F1SLP/Tracking-VFO-pour-YAESU-FT-817-et-FT-818-Arduino/Oled screen.jpg

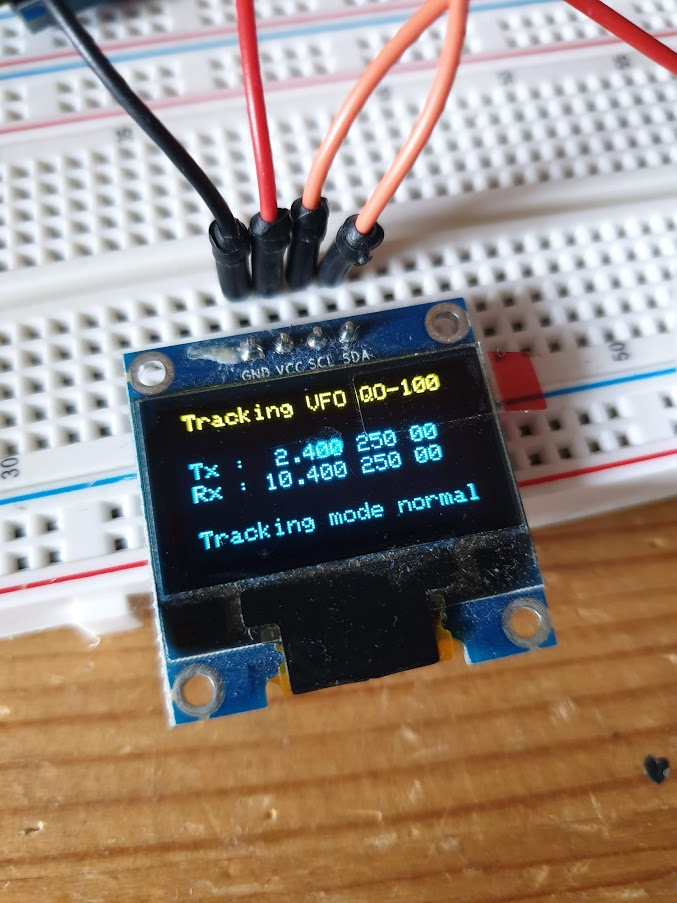
Oled screen.jpg
