F1SLP/Tracking-VFO-pour-YAESU-FT-817-et-FT-818-Arduino/Tracking_LCD_SLP.jpg

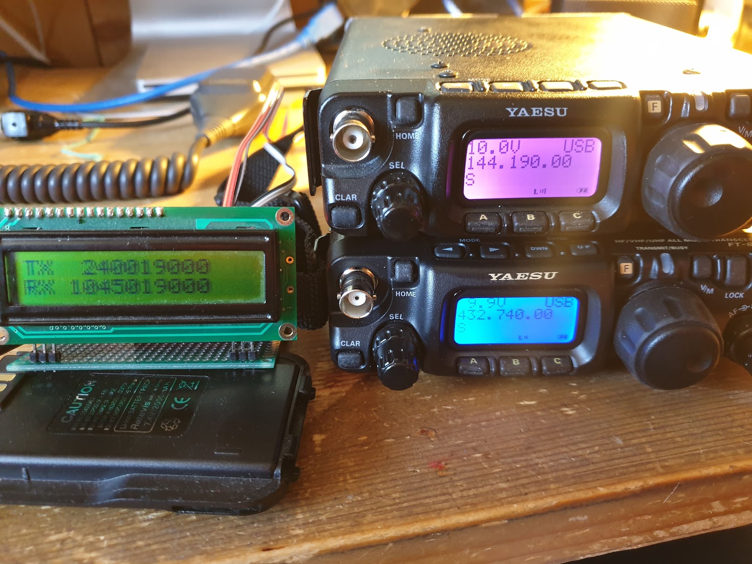
Tracking_LCD_SLP.jpg
