F1SLP/Tracking-VFO-pour-YAESU-FT-817-et-FT-818-Arduino/Schematic_Tracking FT817 LCD I2C_2020-08-15_14-18-44.pdf

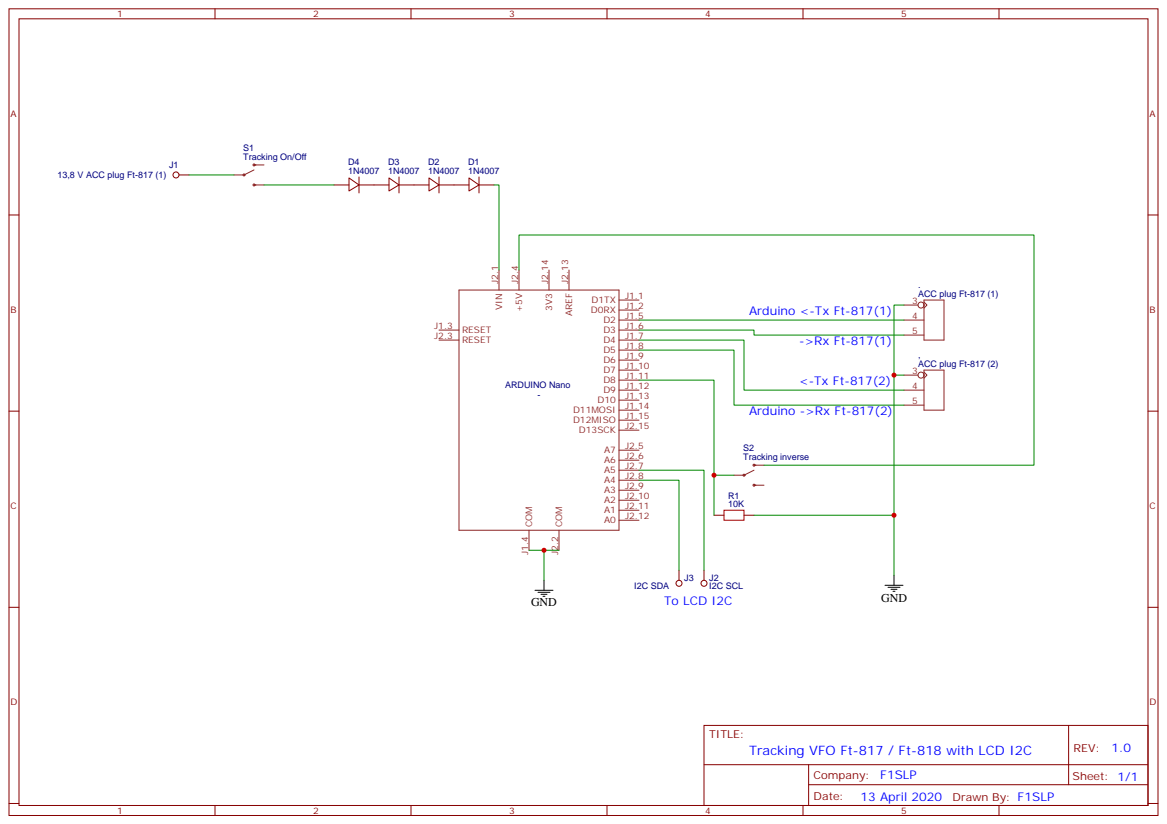
[picture p3: page 1]
