F1SLP/Tracking-VFO-pour-YAESU-FT-817-et-FT-818-Arduino/Schematic_Tracking FT-817 and FT-818_2020-08-15_14-14-17.pdf

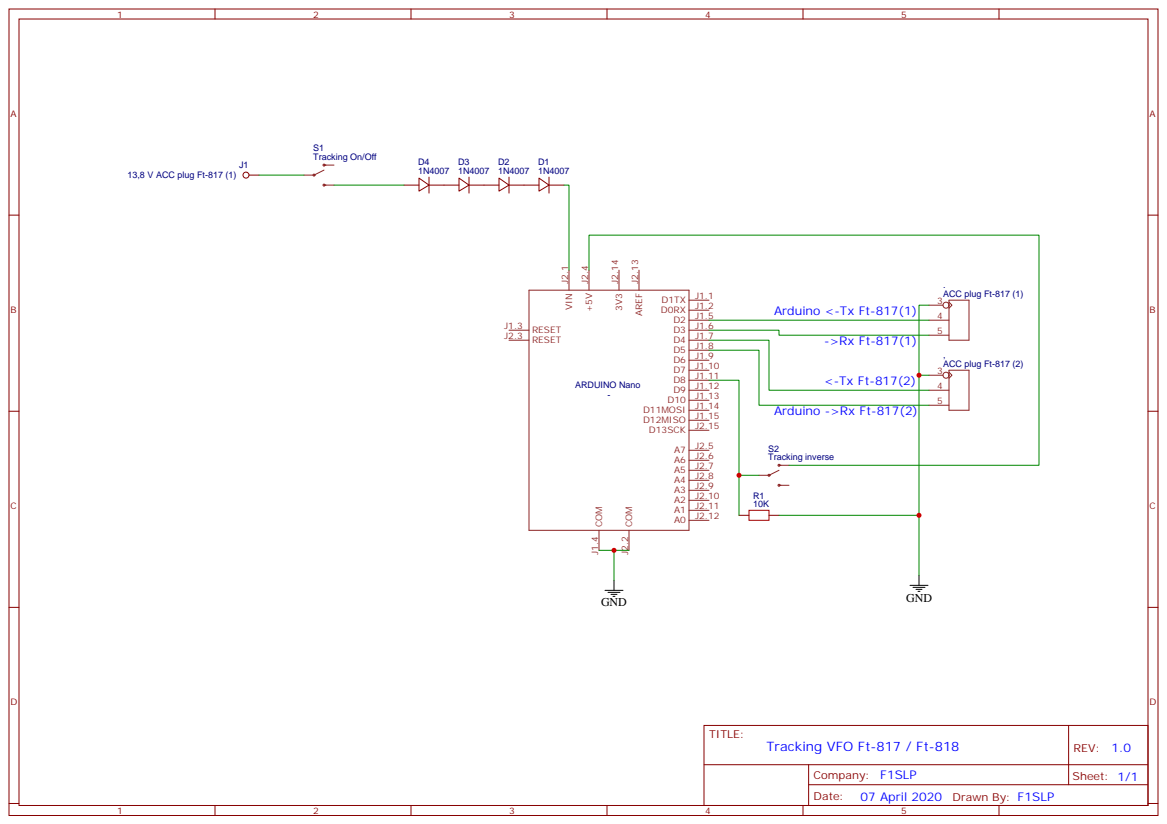
[picture p4: page 1]
